flyoob/NanoVNA-F/Img/RF_Demo_Kit_Bot.jpg

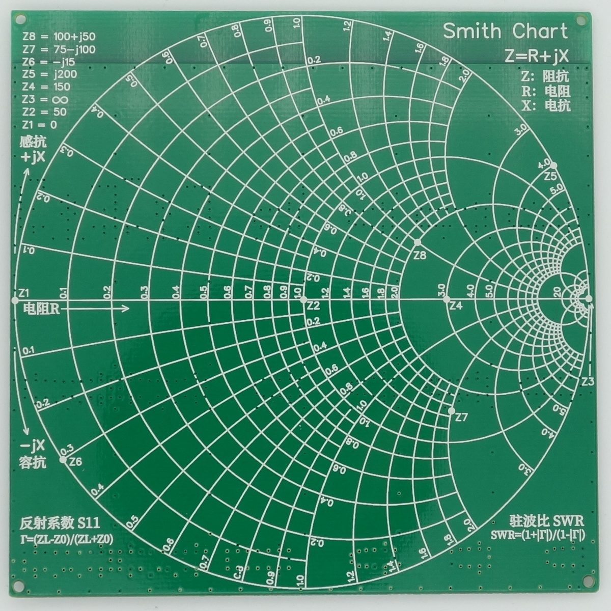
Img/RF_Demo_Kit_Bot.jpg
