flyoob/NanoVNA-F/Img/NanoVNA-F_PCB_V2.2_F.JPG

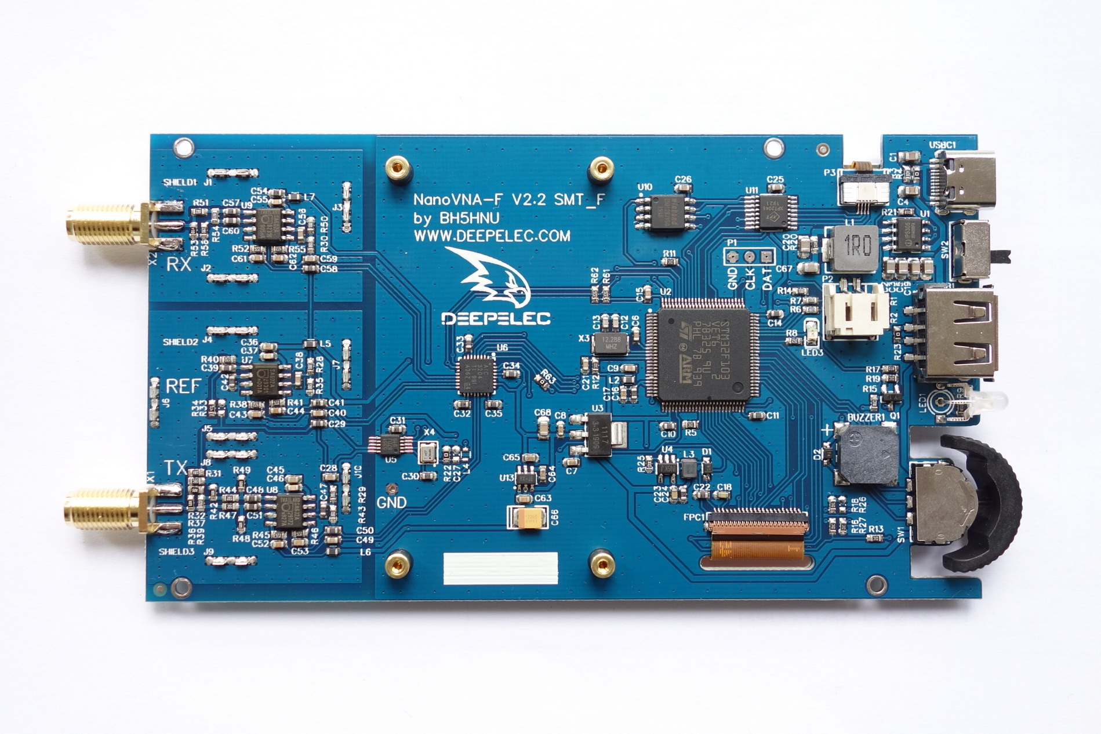
Img/NanoVNA-F_PCB_V2.2_F.JPG
