flyoob/NanoVNA-F/Img/NanoVNA-F_样品谍照1.JPG

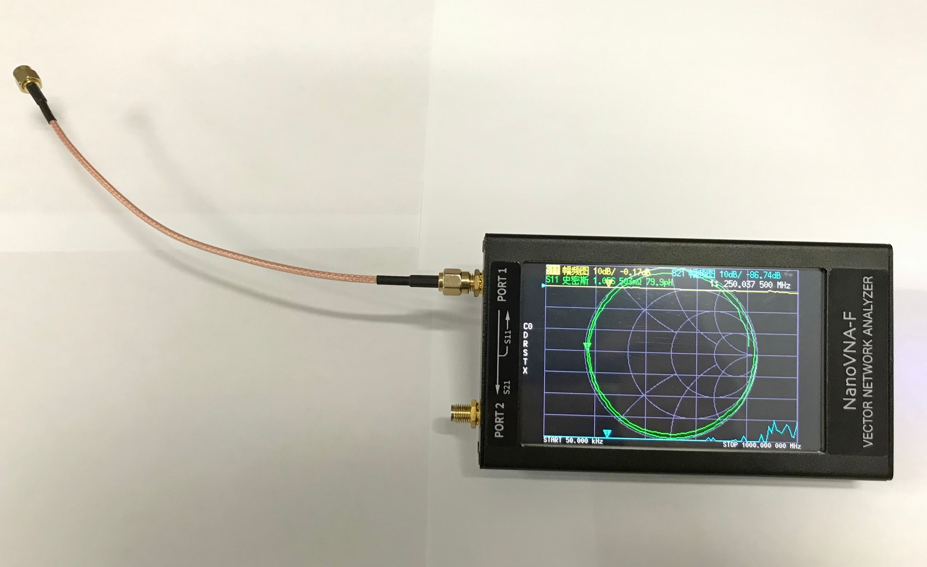
Img/NanoVNA-F_样品谍照1.JPG
