flyoob/NanoVNA-F/Img/RF_Demo_Kit_Top.jpg

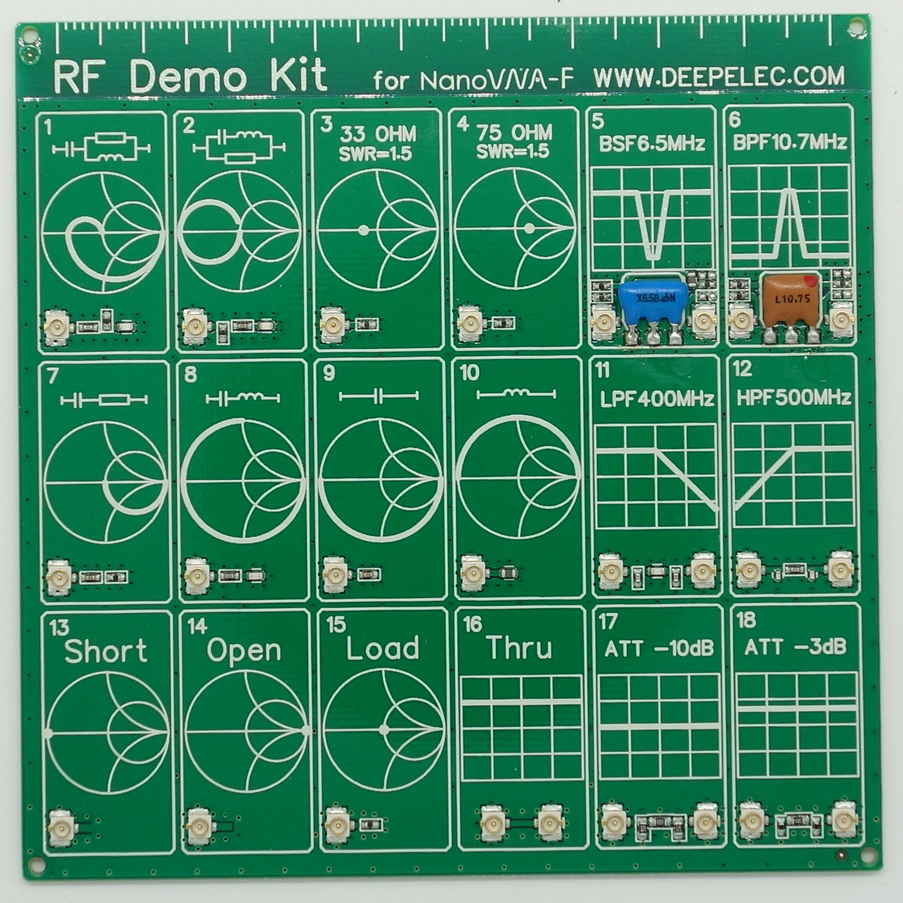
Img/RF_Demo_Kit_Top.jpg
