flyoob/NanoVNA-F/(threads)

Thread 6 (2019-11-22):

Update to 0.5.0 release

Constantin07, 2019-11-22:
Hi,

Are the any plans to update firmware to 0.5.0 release based on  https://github.com/ttrftech/NanoVNA/releases ?

Thanks.

PS: Great work and good product by the way.

flyoob, 2019-12-04:
> Are the any plans to update firmware to 0.5.0 release based on

We prioritize bug fixes, and new features released by edy555 will gradually follow up, please be patient ~

Closed 2019-12-04.

Thread 7 (2019-12-02):

Calibration problems at rev 0.0.4

derfunker, 2019-12-02:
Something is wrong with the CAL routines...
When doing S11 and S21 Calibration the errror terms are displayed on screen as described.
But when the correction is activated only the S11 trace is corrected!
Only when I have one trace (S21) on screen the correction works.
In some cases the S11 sweep only works when the marker is set e.g. to center.
I think here are some minor software bugs to find. In principle the device works fine! Thank you!

derfunker, 2019-12-02:
I found it. The bug was sitting in front of the device :-) Now I was successful with the Cal.

flyoob, 2019-12-04:
Thank you for your feedback, we will continue to pay attention to this issue.

derfunker, 2019-12-04:
Thanks!
One question: what is the maximum rf input level at port 2 (in case of
measure of an active DUT) I would apriciate to know about any new software
updates.
Best regards, Klaus

BH5HNU <notifications@github.com> schrieb am Mi., 4. Dez. 2019, 12:49:

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

Thread 8 (2019-12-04):

Informational commands on the serial port: "version" and "info"

mihtjel, 2019-12-04:
Hello,
for NanoVNA-Saver, it would be a help if the following were implemented in the NanoVNA-F firmware:

1) A "version" command, returning something like, for example: "NanoVNA-F version 0.0.5"
Having the version number clearly separated by spaces from the rest of the string is an advantage for my current parsing method. ;-)

2) An "info" command, returning at least the string "NanoVNA-F" (in order to recognize the device), but preferably also for example the supported frequency span, and any additional features supported by the firmware revision. Should you include a "raw scan" command at some point, that could be noted there, for example.  This would allow the software to distinguish not just which functions are available, but also which versions of the functions, should they change over time in an incompatible manner.

Thank you for your support in developing NanoVNA-Saver! I am testing it out with the NanoVNA-F right now! :-)

flyoob, 2019-12-04:
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

OK, I will add these commands in the next firmware update.
Have fun with your -F machine ~ :-)

Closed 2019-12-30.

Thread 9 (2019-12-08):

Enhancement: capture command for screenshots

mihtjel, 2019-12-08:
The NanoVNA-H firmware and variants has a "capture" command which returns the raw screen data, which can be used to make screenshots of the device. I'm adding support for this to NanoVNA-Saver. If you were to add a similar facility to the NanoVNA-F firmware, I would want to support this as well. :-)

mihtjel, 2020-02-24:
I see that a capture command has been added. However, it seems to send erroneous data: Cyan is sent the same way as white, ie. as 0xFFFF. I think that's a bug?

Thread 16 (2020-03-28):

Overlapping text displayed

Constantin07, 2020-03-28:
In some situations the displayed text overlaps. See attached the screenshot.

In my opinion (my 2 cents), SWR doesn't need much space so may be can be moved a bit to right ?

Version: 0.1.4
HW: V2.2

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

Thread 17 (2020-04-05):

Enhancement: Cho45 or Android app compatability

intelmation, 2020-04-05:
The VNA-H series has a nice, albeit no longer updated, Android app written by Cho45.

Would be nice to makr the "F" work with it. I believe it's a "com port" issue as my app shows a communication port error and will not connect.

Thanks!

flyoob, 2020-04-14:
Hi, to connect to the Android App, you need:
for NanoVNA-F HW V2.2, use USB-C to USB-C (OTG required) cable;
for NanoVNA-F HW V3.1 & V2.3, use USB-C to USB-C (No OTG required) cable.
Please confirm that the correct cable is used, thank you !

dsiminiuk, 2020-07-26:
HW 3.1 and USB-C to USB-C cable works.

Thread 18 (2020-07-25):

Touch calbration

Red-Owl, 2020-07-25:
hi,
in the new release touch screen have a little problem to touch.
(before calibration, after calibration) after update a new version.
version 2.

Thread 23 (2020-11-04):

Quick Start Guide Error

ricknun, 2020-11-04:
"NanoVNA-F Quick start guide - Firmware 0.2.1", 24 Aug 2020, Release 3.1, CONFIG, ABOUT shows a display image. That image is very different than the image on the device.  See the image for what it should look like.
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

Thread 26 (2021-07-02):

Abandoned?

ikidd, 2021-07-02:
Just purchased a NanoVNC-F and I see this firmware is pretty old.  Getting errors on calibration about unplausible values and most of what I see says to update firmware.  Am I whistling in the wind to think this project will get attention in the future or did I buy a paperweight?
