flyoob/NanoVNA-F/nanoVNA-F schematic_rev2.pdf

# nanoVNA-F

## USB1

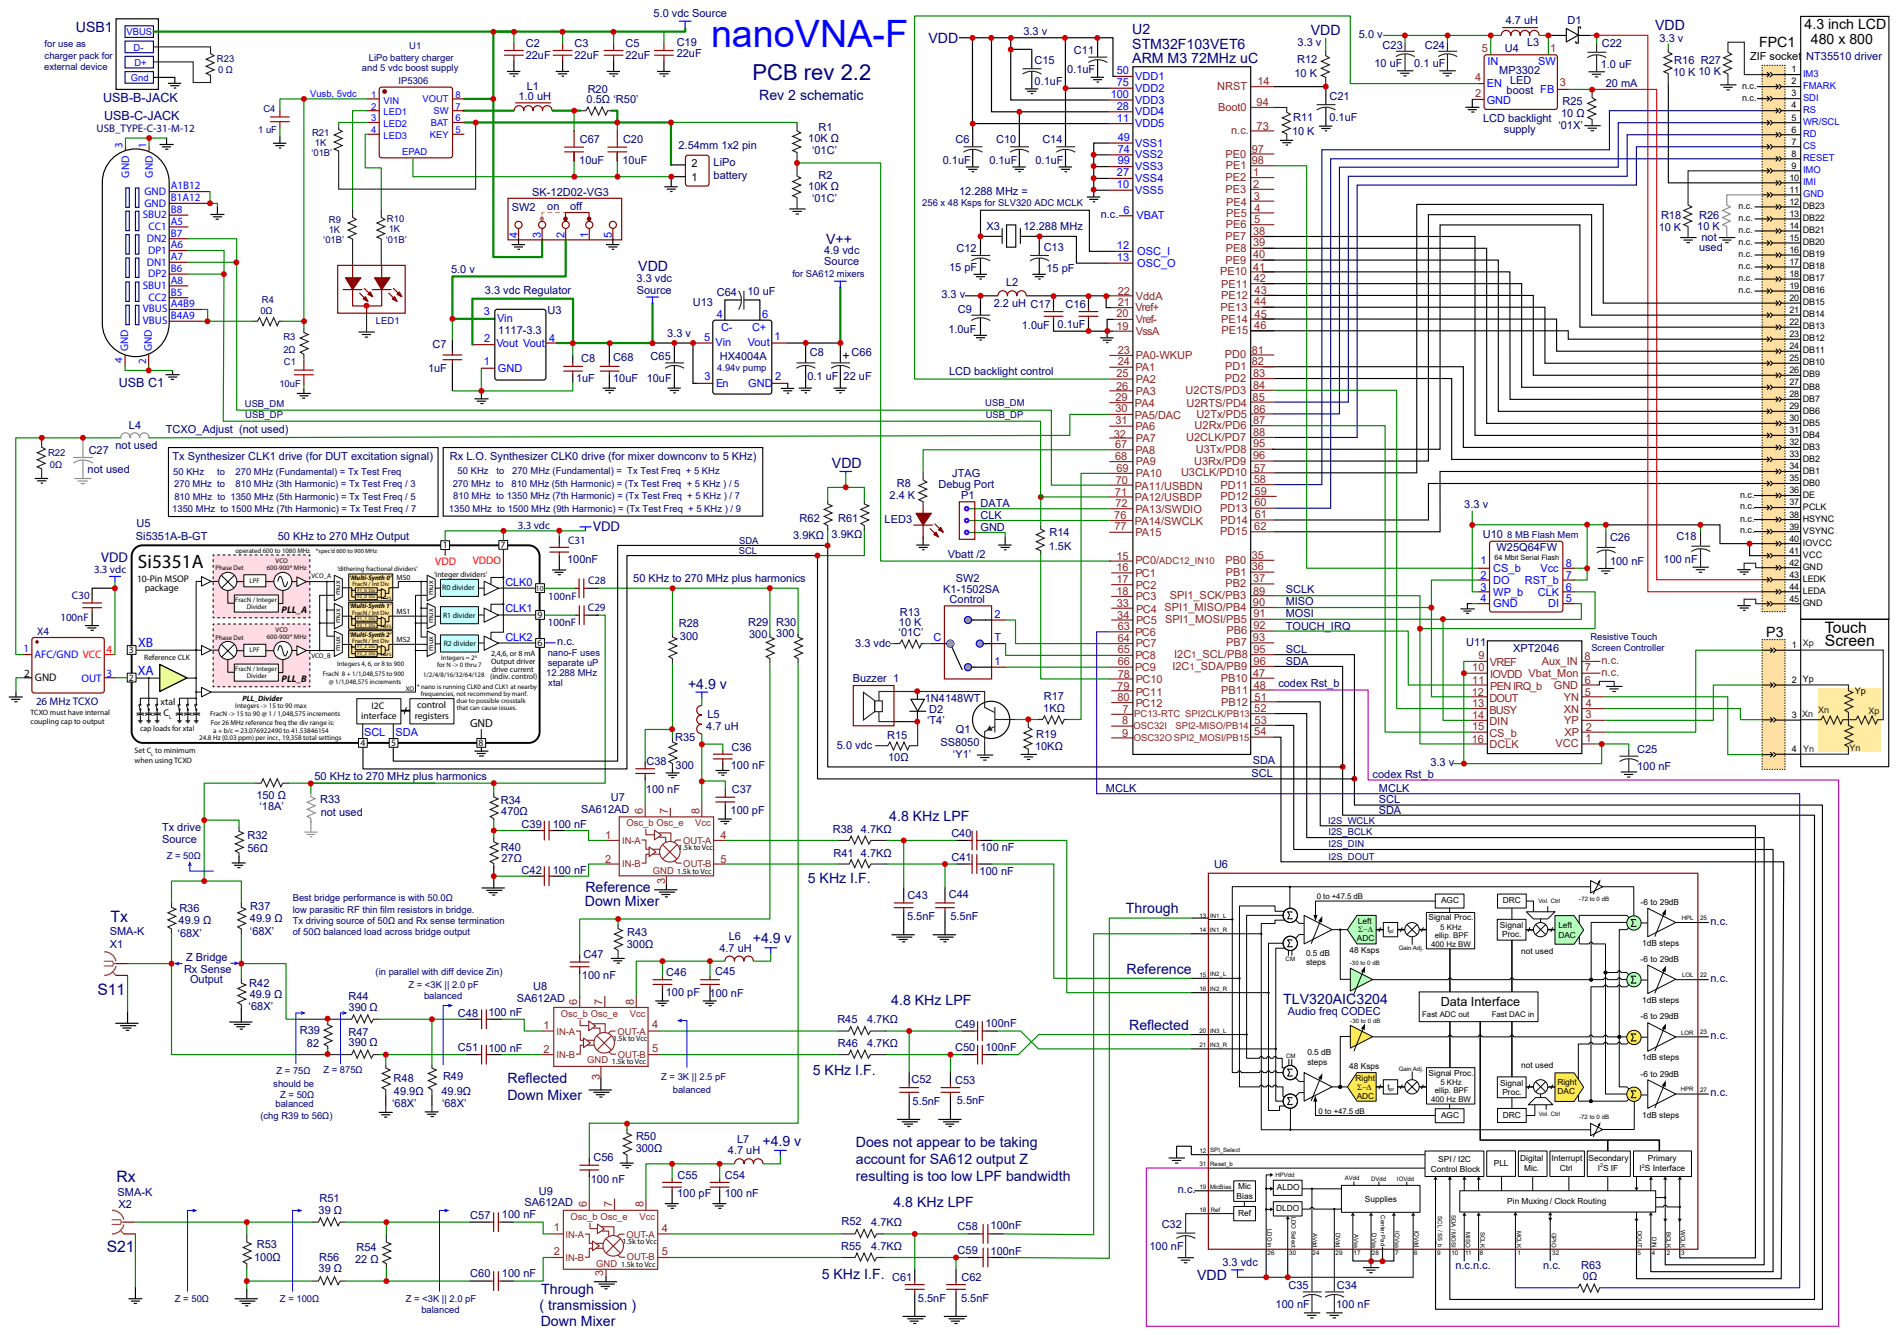
[picture p5: page 1]

12.288 MHz =
256 x 48 Ksps for SLV320 ADC MCLK

TCXO_Adjust (not used)
Tx Synthesizer CLK1 drive (for DUT excitation signal)
50 KHz to 270 MHz (Fundamental) = Tx Test Freq
270 MHz to 810 MHz (3th Harmonic) = Tx Test Freq / 3
810 MHz to 1350 MHz (5th Harmonic) = Tx Test Freq / 5
1350 MHz to 1500 MHz (7th Harmonic) = Tx Test Freq / 7
VDD

Rx L.O. Synthesizer CLK0 drive (for mixer downconv to 5 KHz)
50 KHz to 270 MHz (Fundamental) = Tx Test Freq + 5 KHz
270 MHz to 810 MHz (5th Harmonic) = (Tx Test Freq + 5 KHz ) / 5
810 MHz to 1350 MHz (7th Harmonic) = (Tx Test Freq + 5 KHz ) / 7
1350 MHz to 1500 MHz (9th Harmonic) = (Tx Test Freq + 5 KHz ) / 9

50 KHz to 270 MHz Output

operated 600 to 1080 MHz *spec’d 600 to 900 MHz

50 KHz to 270 MHz plus harmonics

Integers = 2N
for N -> 0 thru 7
* nano is running CLK0 and CLK1 at nearby
frequencies, not recommend by manf.
control
SDA
SCL

26 MHz TCXO
TCXO must have internal
coupling cap to output

xtal
cap loads for xtal

PLL_Divider
Integers -> 15 to 90 max
FracN -> 15 to 90 @ 1 / 1,048,575 increments
For 26 MHz reference freq the div range is:
24.8 Hz (0.03 ppm) per incr., 19,358 total settings

due to possible crosstalk
that can cause issues.

not used

MCLK | | MCLK

low parasitic RF thin film resistors in bridge.
Tx driving source of 50Ω and Rx sense termination
of 50Ω balanced load across bridge output

(in parallel with diff device Zin)
balanced

Does not appear to be taking
account for SA612 output Z
resulting is too low LPF bandwidth
4.8 KHz LPF

Pin Muxing / Clock Routing
