flyoob/NanoVNA-F/Src/main.c

/**
  ******************************************************************************
  * @file           : main.c
  * @brief          : Main program body
  ******************************************************************************
  * This notice applies to any and all portions of this file
  * that are not between comment pairs USER CODE BEGIN and
  * USER CODE END. Other portions of this file, whether 
  * inserted by the user or by software development tools
  * are owned by their respective copyright owners.
  *
  * Copyright (c) 2019 STMicroelectronics International N.V. 
  * All rights reserved.
  *
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
  ******************************************************************************
  */
/* Includes ------------------------------------------------------------------*/
#include "main.h"
#include "stm32f1xx_hal.h"
#include "cmsis_os.h"
#include "fatfs.h"
#include "usb_device.h"

/* USER CODE BEGIN Includes */
#include "board.h"
/* USER CODE END Includes */

ADC_HandleTypeDef hadc1;
ADC_HandleTypeDef hadc2;

I2S_HandleTypeDef hi2s2;
DMA_HandleTypeDef hdma_spi2_rx;

SPI_HandleTypeDef hspi1;
DMA_HandleTypeDef hdma_spi1_tx;
DMA_HandleTypeDef hdma_spi1_rx;

TIM_HandleTypeDef htim1;
TIM_HandleTypeDef htim2;
DMA_HandleTypeDef hdma_tim1_ch3;

SRAM_HandleTypeDef hsram1;

osThreadId Task001Handle;
osThreadId TaskCmdHandle;

/* USER CODE BEGIN PV */
FIL fil;
UINT size;
char callsign[11];
/* USER CODE END PV */

void SystemClock_Config(void);
static void MX_GPIO_Init(void);
static void MX_DMA_Init(void);
static void MX_FSMC_Init(void);
static void MX_I2S2_Init(void);
static void MX_TIM1_Init(void);
static void MX_SPI1_Init(void);
static void MX_TIM2_Init(void);
static void MX_ADC2_Init(void);
static void MX_ADC1_Init(void);
void StartTask001(void const * argument);
void StartTaskCmd(void const * argument);

void HAL_TIM_MspPostInit(TIM_HandleTypeDef *htim);
                                
                                

/* USER CODE BEGIN PFP */
extern void app_init(void);
extern void app_loop(void);
extern void cmd_init(void);
extern void cmd_loop(void);

static void MY_USBDP_IO_Init(void)
{
  GPIO_InitTypeDef GPIO_InitStruct;

  HAL_GPIO_WritePin(GPIOC, GPIO_PIN_10, GPIO_PIN_SET);

  GPIO_InitStruct.Pin = GPIO_PIN_10;
  GPIO_InitStruct.Mode = GPIO_MODE_OUTPUT_PP;
  GPIO_InitStruct.Pull = GPIO_PULLUP;
  GPIO_InitStruct.Speed = GPIO_SPEED_FREQ_HIGH;
  HAL_GPIO_Init(GPIOC, &GPIO_InitStruct);
}

static void MX_SPI1_Init_SF(void)
{

  /* SPI1 parameter configuration*/
  hspi1.Instance = SPI1;
  hspi1.Init.Mode = SPI_MODE_MASTER;
  hspi1.Init.Direction = SPI_DIRECTION_2LINES;
  hspi1.Init.DataSize = SPI_DATASIZE_8BIT;
  hspi1.Init.CLKPolarity = SPI_POLARITY_HIGH;
  hspi1.Init.CLKPhase = SPI_PHASE_2EDGE;
  hspi1.Init.NSS = SPI_NSS_SOFT;
  hspi1.Init.BaudRatePrescaler = SPI_BAUDRATEPRESCALER_2;
  hspi1.Init.FirstBit = SPI_FIRSTBIT_MSB;
  hspi1.Init.TIMode = SPI_TIMODE_DISABLE;
  hspi1.Init.CRCCalculation = SPI_CRCCALCULATION_DISABLE;
  hspi1.Init.CRCPolynomial = 10;
  if (HAL_SPI_Init(&hspi1) != HAL_OK)
  {
    _Error_Handler(__FILE__, __LINE__);
  }

}
/* USER CODE END PFP */

/**
  * @brief  The application entry point.
  *
  * @retval None
  */
int main(void)
{
  /* USER CODE BEGIN 1 */
  SCB->VTOR = FLASH_BASE | FLASH_BOOT_SIZE;
  /* USER CODE END 1 */

  /* MCU Configuration----------------------------------------------------------*/

  /* Reset of all peripherals, Initializes the Flash interface and the Systick. */
  HAL_Init();

  /* Configure the system clock */
  SystemClock_Config();

  /* Initialize all configured peripherals */
  MX_GPIO_Init();
  MX_DMA_Init();
  MX_FSMC_Init();
  MX_I2S2_Init();
  MX_TIM1_Init();
  MX_TIM2_Init();
  MX_ADC2_Init();
  MX_ADC1_Init();
  /* USER CODE BEGIN 2 */
  __enable_irq();
  /* USER CODE END 2 */

  /* USER CODE BEGIN RTOS_MUTEX */
  /* add mutexes, ... */
  /* USER CODE END RTOS_MUTEX */

  /* USER CODE BEGIN RTOS_SEMAPHORES */
  /* add semaphores, ... */
  /* USER CODE END RTOS_SEMAPHORES */

  /* USER CODE BEGIN RTOS_TIMERS */
  /* start timers, add new ones, ... */
  /* USER CODE END RTOS_TIMERS */

  /* Create the thread(s) */
  /* definition and creation of Task001 */
  osThreadDef(Task001, StartTask001, osPriorityNormal, 0, 512);
  Task001Handle = osThreadCreate(osThread(Task001), NULL);

  /* definition and creation of TaskCmd */
  osThreadDef(TaskCmd, StartTaskCmd, osPriorityNormal, 0, 512);
  TaskCmdHandle = osThreadCreate(osThread(TaskCmd), NULL);

  /* USER CODE BEGIN RTOS_THREADS */
  /* add threads, ... */
  /* USER CODE END RTOS_THREADS */

  /* USER CODE BEGIN RTOS_QUEUES */
  /* add queues, ... */
  /* USER CODE END RTOS_QUEUES */
 

  /* Start scheduler */
  osKernelStart();
  
  /* We should never get here as control is now taken by the scheduler */

  /* Infinite loop */
  /* USER CODE BEGIN WHILE */
  while (1)
  {

  /* USER CODE END WHILE */

  /* USER CODE BEGIN 3 */

  }
  /* USER CODE END 3 */

}

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
/* USER CODE BEGIN Header_StartTask001 */
/**
  * @brief  Function implementing the MyTask001 thread.
  * @param  argument: Not used 
  * @retval None
  */
/* USER CODE END Header_StartTask001 */
void StartTask001(void const * argument)
{
  /* USER CODE BEGIN 5 */
  MY_USBDP_IO_Init();
  MX_USB_DEVICE_Init();

  MX_SPI1_Init_SF();

  // Register
  MX_FATFS_Init();
  if (retUSER != 0) {
    goto INIT;
  }
  // Mount
  if (f_mount(&USERFatFS, (TCHAR const*)USERPath, 1) != FR_OK) {
    goto INIT;
  }
  // Open Callsign File
  callsign[0] = 0; // (nul == null char) init nul callsign before use
 
  // consider callsign <"abcdefghil0123456789\r\n\0"|"abcdefghil0123456789\n\0"|"abcdefghil0123456789\0">
  if (f_open(&fil, "callsign.txt", FA_OPEN_EXISTING | FA_READ) == FR_OK) {
    DWORD size;
   
    f_lseek(&fil, 0);
   
    if ((size = f_size(&fil)) > 0) {
      UINT cp;
     
      f_read(&fil, (uint8_t *)callsign, 10, &size); // load max 10 chars
     
      if (size < 11) { callsign[size] = 0; } // 11 == CMAX+1
      else { callsign[10] = 0; } // truncate at 10th char
     
      for (cp = 0; callsign[cp] != '\r' && callsign[cp] != '\n' && callsign[cp] != 0; cp++); // lazy eval: find \r or \n or null
     
      if (callsign[cp] != 0) { callsign[cp] = 0; } // nul terminate else no-op
    } // (size > 0) else no-op
  } // FR_OK else no-op
 
  f_close(&fil);
  // Unmount
  f_mount(NULL, (TCHAR const*)USERPath, 1);

INIT:
  HAL_SPI_DeInit(&hspi1);
  MX_SPI1_Init();

  app_init();
  /* Infinite loop */
  for(;;)
  {
    app_loop();
    osDelay(1);
  }
  /* USER CODE END 5 */ 
}

/* USER CODE BEGIN Header_StartTaskCmd */
/**
* @brief Function implementing the myTaskCmd thread.
* @param argument: Not used
* @retval None
*/
/* USER CODE END Header_StartTaskCmd */
void StartTaskCmd(void const * argument)
{
  /* USER CODE BEGIN StartTaskCmd */
  cmd_init();
  /* Infinite loop */
  for(;;)
  {
    cmd_loop();
    osDelay(1);
  }
  /* USER CODE END StartTaskCmd */
}

/**
  * @brief  Period elapsed callback in non blocking mode
  * @note   This function is called  when TIM4 interrupt took place, inside
  * HAL_TIM_IRQHandler(). It makes a direct call to HAL_IncTick() to increment
  * a global variable "uwTick" used as application time base.
  * @param  htim : TIM handle
  * @retval None
  */
void HAL_TIM_PeriodElapsedCallback(TIM_HandleTypeDef *htim)
{
  if (htim->Instance == TIM4) {
    HAL_IncTick();
  }
  /* USER CODE BEGIN Callback 1 */
  beep_tick();
  /* USER CODE END Callback 1 */
}

/**
  * @brief  This function is executed in case of error occurrence.
  * @param  file: The file name as string.
  * @param  line: The line in file as a number.
  * @retval None
  */
void _Error_Handler(char *file, int line)
{
  /* USER CODE BEGIN Error_Handler_Debug */
  /* User can add his own implementation to report the HAL error return state */
  printf("_Error_Handler %s(%d)-<%s>: \r\n",__FILE__, __LINE__, __FUNCTION__);
  while(1)
  {
  }
  /* USER CODE END Error_Handler_Debug */
}

#ifdef  USE_FULL_ASSERT
/**
  * @brief  Reports the name of the source file and the source line number
  *         where the assert_param error has occurred.
  * @param  file: pointer to the source file name
  * @param  line: assert_param error line source number
  * @retval None
  */
void assert_failed(uint8_t* file, uint32_t line)
{ 
  /* USER CODE BEGIN 6 */
  /* User can add his own implementation to report the file name and line number,
     tex: printf("Wrong parameters value: file %s on line %d\r\n", file, line) */
  /* USER CODE END 6 */
}
#endif /* USE_FULL_ASSERT */

/**
  * @}
  */

/**
  * @}
  */

/************************ (C) COPYRIGHT STMicroelectronics *****END OF FILE****/
