flyoob/NanoVNA-F/NanoVNA-F.ioc

Mcu.UserName=STM32F103VETx
PA10.GPIO_Label=BEEP
PA10.Signal=S_TIM1_CH3
PA11.Signal=USB_DM
PA12.Signal=USB_DP
PA13.Signal=SYS_JTMS-SWDIO
PA14.Signal=SYS_JTCK-SWCLK
PA2.GPIO_Label=LED_PWM
PA2.Signal=S_TIM2_CH3
PA8.GPIO_Label=LED1
PA8.Signal=GPIO_Output
PB11.GPIO_Label=AIC_RST
PB11.Signal=GPIO_Output
PB12.GPIO_Label=I2S_WCLK
PB12.Signal=I2S2_WS
PB13.GPIO_Label=I2S_BCLK
PB13.Signal=I2S2_CK
PB15.GPIO_Label=I2S_DOUT
PB15.Signal=I2S2_SD
PB3.GPIO_Label=SPI_SCK
PB3.Signal=SPI1_SCK
PB4.GPIO_Label=SPI_MISO
PB4.Signal=SPI1_MISO
PB5.GPIO_Label=SPI_MOSI
PB5.Signal=SPI1_MOSI
PB6.GPIO_Label=TP_IRQ
PB6.Signal=GPXTI6
PC0.GPIO_Label=BAT_ADC
PC0.Signal=ADCx_IN10
PC6.Signal=I2S2_MCK
PC7.GPIO_Label=K_UP
PC7.Signal=GPXTI7
PC8.GPIO_Label=K_PUSH
PC8.Signal=GPXTI8
PC9.GPIO_Label=K_DOWN
PC9.Signal=GPXTI9
PD0.Signal=FSMC_D2
PD1.Signal=FSMC_D3
PD10.Signal=FSMC_D15
PD11.Signal=FSMC_A16
PD13.GPIO_Label=LCD_RST
PD13.Signal=GPIO_Output
PD14.Signal=FSMC_D0
PD15.Signal=FSMC_D1
PD3.GPIO_Label=TP_BUSY
PD3.Signal=GPIO_Input
PD4.Signal=FSMC_NOE
PD5.Signal=FSMC_NWE
PD6.GPIO_Label=SPI_CS0
PD6.Signal=GPIO_Output
PD7.Signal=FSMC_NE1
PD8.Signal=FSMC_D13
PD9.Signal=FSMC_D14
PE1.GPIO_Label=SPI_CS1
PE1.Signal=GPIO_Output
PE10.Signal=FSMC_D7
PE11.Signal=FSMC_D8
PE12.Signal=FSMC_D9
PE13.Signal=FSMC_D10
PE14.Signal=FSMC_D11
PE15.Signal=FSMC_D12
PE7.Signal=FSMC_D4
PE8.Signal=FSMC_D5
PE9.Signal=FSMC_D6
