flyoob/NanoVNA-F/Usr/plot.c

#include <math.h>
#include <string.h>
#include "system.h"
#include "cmsis_os.h"
#include "board.h"
#include "nanovna.h"

#define SWAP(x,y) do { int z=x; x = y; y = z; } while(0)

void cell_draw_marker_info(int m, int n, int w, int h);
void draw_frequencies(void);
void frequency_string(char *buf, size_t len, int32_t freq);
void markmap_all_markers(void);

/* indicate dirty cells */
uint16_t markmap[2][8];
uint16_t current_mappage = 0;

int32_t fgrid = 50000000;
int16_t grid_offset;
int16_t grid_width;

int area_width = AREA_WIDTH_NORMAL;
int area_height = HEIGHT;

#define GRID_RECTANGULAR (1<<0)
#define GRID_SMITH       (1<<1)
#define GRID_ADMIT       (1<<2)
#define GRID_POLAR       (1<<3)


#define CELLWIDTH        32
#define CELLHEIGHT       32

/*
 * CELL_X0[27:31] cell position 0-31
 * CELL_Y0[22:26] cell position 0-31
 * CELL_N[10:21]  original order 0-4095
 * CELL_X[5:9]    position in the cell 0-31
 * CELL_Y[0:4]    position in the cell 0-31
 */
uint32_t trace_index[TRACES_MAX][SWEEP_POINTS];

#define INDEX(x, y, n) \
  ((((x)&0x03e0UL)<<22) | (((y)&0x03e0UL)<<17) | (((n)&0x0fffUL)<<10)  \
 | (((x)&0x1fUL)<<5) | ((y)&0x1fUL))

#define CELL_X(i)          (int)((((i)>>5)&0x1f) | (((i)>>22)&0x03e0))
#define CELL_Y(i)          (int)(((i)&0x1f) | (((i)>>17)&0x03e0))
#define CELL_N(i)          (int)(((i)>>10)&0xfff)

#define CELL_X0(i)         (int)(((i)>>22)&0x03e0)  // 10bit中的高5bit
#define CELL_Y0(i)         (int)(((i)>>17)&0x03e0)  // 10bit中的高5bit

#define CELL_P(i, x, y)    (((((x)&0x03e0UL)<<22) | (((y)&0x03e0UL)<<17)) == ((i)&0xffc00000UL))


void update_grid(void)
{
  int32_t gdigit = 100000000; // 100M
  int32_t fstart, fspan;
  int32_t grid;
  if (frequency1 > 0) {
    fstart = frequency0;
    fspan = frequency1 - frequency0;
  } else {
    fspan = -frequency1;
    fstart = frequency0 - fspan/2;
  }
  
  while (gdigit > 100) {
    grid = 5 * gdigit;
    if (fspan / grid >= 4)
      break;
    grid = 2 * gdigit;
    if (fspan / grid >= 4)
      break;
    grid = gdigit;
    if (fspan / grid >= 4)
      break;
    gdigit /= 10;
  }
  fgrid = grid;

  grid_offset = (WIDTH-1) * ((fstart % fgrid) / 100) / (fspan / 100);
  grid_width = (WIDTH-1) * (fgrid / 100) / (fspan / 1000);

  force_set_markmap();
  draw_frequencies();
}

int
circle_inout(int x, int y, int r)
{
  int d = x*x + y*y - r*r;
  if (d <= -r)
    return 1;
  if (d > r)
    return -1;
  return 0;
}

#if USE_ILI_LCD

#define P_CENTER_X      146
#define P_CENTER_Y      116
#define P_RADIUS        116

#else

#define P_CENTER_X    ((WIDTH-1)/2)
#define P_CENTER_Y      116
#define P_RADIUS        116

#endif

int
polar_grid(int x, int y)
{
  int c = config.grid_color;
  int d;

  // offset to center
  x -= P_CENTER_X;
  y -= P_CENTER_Y;

  // outer circle
  d = circle_inout(x, y, P_RADIUS);
  if (d < 0) return 0;
  if (d == 0) return c;

  // vertical and horizontal axis
  if (x == 0 || y == 0)
    return c;

  d = circle_inout(x, y, P_RADIUS / 5);
  if (d == 0) return c;
  if (d > 0) return 0;

  d = circle_inout(x, y, P_RADIUS * 2 / 5);
  if (d == 0) return c;
  if (d > 0) return 0;

  // cross sloping lines
  if (x == y || x == -y)
    return c;

  d = circle_inout(x, y, P_RADIUS * 3 / 5);
  if (d == 0) return c;
  if (d > 0) return 0;

  d = circle_inout(x, y, P_RADIUS * 4 / 5);
  if (d == 0) return c;
  return 0;
}

/*
 * Constant Resistance circle: (u - r/(r+1))^2 + v^2 = 1/(r+1)^2
 * Constant Reactance circle:  (u - 1)^2 + (v-1/x)^2 = 1/x^2
 */
int
smith_grid(int x, int y)
{
  int c = config.grid_color;
  int d;

  // offset to center
  x -= P_CENTER_X;
  y -= P_CENTER_Y;
  
  // outer circle
  d = circle_inout(x, y, P_RADIUS);
  if (d < 0)
    return 0;
  if (d == 0)
    return c;
  
  // horizontal axis
  if (y == 0)
    return c;

  // shift circle center to right origin
  x -= P_RADIUS;

  // Constant Reactance Circle: 2j : R/2 = 58
  if (circle_inout(x, y+58, 58) == 0)
    return c;
  if (circle_inout(x, y-58, 58) == 0)
    return c;

  // Constant Resistance Circle: 3 : R/4 = 29
  d = circle_inout(x+29, y, 29);
  if (d > 0) return 0;
  if (d == 0) return c;

  // Constant Reactance Circle: 1j : R = 116
  if (circle_inout(x, y+116, 116) == 0)
    return c;
  if (circle_inout(x, y-116, 116) == 0)
    return c;

  // Constant Resistance Circle: 1 : R/2 = 58
  d = circle_inout(x+58, y, 58);
  if (d > 0) return 0;
  if (d == 0) return c;

  // Constant Reactance Circle: 1/2j : R*2 = 232
  if (circle_inout(x, y+232, 232) == 0)
    return c;
  if (circle_inout(x, y-232, 232) == 0)
    return c;

  // Constant Resistance Circle: 1/3 : R*3/4 = 87
  if (circle_inout(x+87, y, 87) == 0)
    return c;
  return 0;
}

int
smith_grid2(int x, int y, float scale)
{
  int c = config.grid_color;
  int d;

  // offset to center
  x -= P_CENTER_X;
  y -= P_CENTER_Y;
  
  // outer circle
  d = circle_inout(x, y, P_RADIUS);
  if (d < 0)
    return 0;
  if (d == 0)
    return c;

  // shift circle center to right origin
  x -= P_RADIUS * scale;

  // Constant Reactance Circle: 2j : R/2 = 58
  if (circle_inout(x, y+58*scale, 58*scale) == 0)
    return c;
  if (circle_inout(x, y-58*scale, 58*scale) == 0)
    return c;
#if 0
  // Constant Resistance Circle: 3 : R/4 = 29
  d = circle_inout(x+29*scale, y, 29*scale);
  if (d > 0) return 0;
  if (d == 0) return c;
  d = circle_inout(x-29*scale, y, 29*scale);
  if (d > 0) return 0;
  if (d == 0) return c;
#endif

  // Constant Reactance Circle: 1j : R = 116
  if (circle_inout(x, y+116*scale, 116*scale) == 0)
    return c;
  if (circle_inout(x, y-116*scale, 116*scale) == 0)
    return c;

  // Constant Resistance Circle: 1 : R/2 = 58
  d = circle_inout(x+58*scale, y, 58*scale);
  if (d > 0) return 0;
  if (d == 0) return c;
  d = circle_inout(x-58*scale, y, 58*scale);
  if (d > 0) return 0;
  if (d == 0) return c;

  // Constant Reactance Circle: 1/2j : R*2 = 232
  if (circle_inout(x, y+232*scale, 232*scale) == 0)
    return c;
  if (circle_inout(x, y-232*scale, 232*scale) == 0)
    return c;

#if 0
  // Constant Resistance Circle: 1/3 : R*3/4 = 87
  d = circle_inout(x+87*scale, y, 87*scale);
  if (d > 0) return 0;
  if (d == 0) return c;
  d = circle_inout(x+87*scale, y, 87*scale);
  if (d > 0) return 0;
  if (d == 0) return c;
#endif

  // Constant Resistance Circle: 0 : R
  d = circle_inout(x+P_RADIUS*scale, y, P_RADIUS*scale);
  if (d > 0) return 0;
  if (d == 0) return c;
  d = circle_inout(x-P_RADIUS*scale, y, P_RADIUS*scale);
  if (d > 0) return 0;
  if (d == 0) return c;

  // Constant Resistance Circle: -1/3 : R*3/2 = 174
  d = circle_inout(x+174*scale, y, 174*scale);
  if (d > 0) return 0;
  if (d == 0) return c;
  d = circle_inout(x-174*scale, y, 174*scale);
  //if (d > 0) return 0;
  if (d == 0) return c;
  return 0;
}


const int cirs[][4] = {
  { 0, 58/2, 58/2, 0 },    // Constant Reactance Circle: 2j : R/2 = 58
  { 29/2, 0, 29/2, 1 },    // Constant Resistance Circle: 3 : R/4 = 29
  { 0, 116/2, 116/2, 0 },  // Constant Reactance Circle: 1j : R = 116
  { 58/2, 0, 58/2, 1 },    // Constant Resistance Circle: 1 : R/2 = 58
  { 0, 232/2, 232/2, 0 },  // Constant Reactance Circle: 1/2j : R*2 = 232
  { 87/2, 0, 87/2, 1 },    // Constant Resistance Circle: 1/3 : R*3/4 = 87
  { 0, 464/2, 464/2, 0 },  // Constant Reactance Circle: 1/4j : R*4 = 464
  { 116/2, 0, 116/2, 1 },  // Constant Resistance Circle: 0 : R
  { 174/2, 0, 174/2, 1 },  // Constant Resistance Circle: -1/3 : R*3/2 = 174
  { 0, 0, 0, 0 } // sentinel
};  

int
smith_grid3(int x, int y)
{
  int c = config.grid_color;
  int d;

  // offset to center
  x -= P_CENTER_X;
  y -= P_CENTER_Y;
  
  // outer circle
  d = circle_inout(x, y, P_RADIUS);
  if (d < 0)
    return 0;
  if (d == 0)
    return c;

  // shift circle center to right origin
  x -= P_RADIUS /2;

  int i;
  for (i = 0; cirs[i][2]; i++) {
    d = circle_inout(x+cirs[i][0], y+cirs[i][1], cirs[i][2]);
    if (d == 0)
      return c;
    if (d > 0 && cirs[i][3])
      return 0;
    d = circle_inout(x-cirs[i][0], y-cirs[i][1], cirs[i][2]);
    if (d == 0)
      return c;
    if (d > 0 && cirs[i][3])
      return 0;
  }
  return 0;
}

#if 0
int
rectangular_grid(int x, int y)
{
  int c = config.grid_color;
  //#define FREQ(x) (((x) * (fspan / 1000) / (WIDTH-1)) * 1000 + fstart)
  //int32_t n = FREQ(x-1) / fgrid;
  //int32_t m = FREQ(x) / fgrid;
  //if ((m - n) > 0)
  //if (((x * 6) % (WIDTH-1)) < 6)
  //if (((x - grid_offset) % grid_width) == 0)
  if (x == 0 || x == WIDTH-1)
    return c;
  if ((y % GRIDY) == 0)
    return c;
  if ((((x + grid_offset) * 10) % grid_width) < 10)
    return c;
  return 0;
}
#endif

int
rectangular_grid_x(int x)
{
  int c = config.grid_color;
  if (x < 0)
    return 0;
  if (x == 0 || x == WIDTH)
    return c;
  if ((((x + grid_offset) * 10) % grid_width) < 10)
    return c;
  return 0;
}

int
rectangular_grid_y(int y)
{
  int c = config.grid_color;
  if (y < 0)
    return 0;
  if ((y % GRIDY) == 0)
    return c;
  return 0;
}

#if 0
int
set_strut_grid(int x)
{
  uint16_t *buf = lcd_buffer;
  int y;

  for (y = 0; y < HEIGHT; y++) {
    int c = rectangular_grid(x, y);
    c |= smith_grid(x, y);
    *buf++ = c;
  }
  return y;
}

void
draw_on_strut(int v0, int d, int color)
{
  int v;
  int v1 = v0 + d;
  if (v0 < 0) v0 = 0;
  if (v1 < 0) v1 = 0;
  if (v0 >= HEIGHT) v0 = HEIGHT-1;
  if (v1 >= HEIGHT) v1 = HEIGHT-1;
  if (v0 == v1) {
    v = v0; d = 2;
  } else if (v0 < v1) {
    v = v0; d = v1 - v0 + 1;
  } else {
    v = v1; d = v0 - v1 + 1;
  }
  while (d-- > 0)
    lcd_buffer[v++] |= color;
}
#endif

/*
 * calculate log10(abs(gamma))
 */ 
float logmag(float *v)
{
  if (v[0] == 0 && v[1] == 0) {
    return -INFINITY;
  }
  return log10f(v[0]*v[0] + v[1]*v[1]);
}

/*
 * calculate phase[-2:2] of coefficient
 */ 
float phase(float *v)
{
  return 2 * atan2f(v[1], v[0]) / M_PI;
}

/*
 * calculate abs(gamma) * 8
 */ 
float linear(float *v)
{
  return - sqrtf(v[0]*v[0] + v[1]*v[1]) * 8;
}

/*
 * calculate vswr; (1+gamma)/(1-gamma)
 */ 
float swr(float *v)
{
  float x = sqrtf(v[0]*v[0] + v[1]*v[1]);
  if (x > 1)
    return INFINITY;
  return (1 + x)/(1 - x);
}

#define RADIUS ((HEIGHT-1)/2)
void
cartesian_scale(float re, float im, int *xp, int *yp, float scale)
{
  //float scale = 4e-3;
  int x = re * RADIUS * scale;
  int y = im * RADIUS * scale;
  if (x < -RADIUS) x = -RADIUS;
  if (y < -RADIUS) y = -RADIUS;
  if (x > RADIUS) x = RADIUS;
  if (y > RADIUS) y = RADIUS;
  *xp = WIDTH/2 + x;
  *yp = HEIGHT/2 - y;
}

/*
=======================================
    x: 每条曲线上点的 X 坐标
    t: 曲线标号
    i: 对应第几个点
=======================================
*/
uint32_t trace_into_index(int x, int t, int i, float coeff[2])
{
  int y = 0;
  float v = 0;
  float refpos = 8 - trace[t].refpos;
  float scale = 1 / trace[t].scale;
  switch (trace[t].type) {
  case TRC_LOGMAG:
    v = refpos - logmag(coeff) * scale;  // t=1, 1-(-3.1) logmag(0)=0
    break;
  case TRC_PHASE:
    v = refpos - phase(coeff) * scale;
    break;
  case TRC_LINEAR:
    v = refpos + linear(coeff) * scale;
    break;
  case TRC_SWR:
    v = refpos+ (1 - swr(coeff)) * scale;
    break;
  case TRC_SMITH:
  //case TRC_ADMIT:
  case TRC_POLAR:
    cartesian_scale(coeff[0], coeff[1], &x, &y, scale);
    return INDEX(x +CELLOFFSETX, y, i);
    // break;
  }
  if (v < 0) v = 0;
  if (v > 8) v = 8;
  y = v * GRIDY;
  return INDEX(x +CELLOFFSETX, y, i);
}

int
string_value_with_prefix(char *buf, int len, float val, char unit)
{
  char prefix;
  int n;
  if (val < 0) {
    val = -val;
    *buf++ = '-';
    len--;
  }
  if (val < 1e-12) {
    prefix = 'f';
    val *= 1e15;
  } else if (val < 1e-9) {
    prefix = 'p';
    val *= 1e12;
  } else if (val < 1e-6) {
    prefix = 'n';
    val *= 1e9;
  } else if (val < 1e-3) {
    prefix = S_MICRO[0];
    val *= 1e6;
  } else if (val < 1) {
    prefix = 'm';
    val *= 1e3;
  } else if (val < 1e3) {
    prefix = 0;
  } else if (val < 1e6) {
    prefix = 'k';
    val /= 1e3;
  } else if (val < 1e9) {
    prefix = 'M';
    val /= 1e6;
  } else {
    prefix = 'G';
    val /= 1e9;
  }

  if (val < 10) {
    n = chsnprintf(buf, len, "%.2f", val);
  } else if (val < 100) {
    n = chsnprintf(buf, len, "%.1f", val);
  } else {
    n = chsnprintf(buf, len, "%d", (int)val);
  }

  if (prefix)
    buf[n++] = prefix;
  if (unit)
    buf[n++] = unit;
  buf[n] = '\0';
  return n;
}


#define PI2 6.283184

void
gamma2imp(char *buf, int len, const float coeff[2], uint32_t frequency)
{
  // z = (gamma+1)/(gamma-1) * z0
  float z0 = 50;
  float d = z0 / ((1-coeff[0])*(1-coeff[0])+coeff[1]*coeff[1]);
  float zr = ((1+coeff[0])*(1-coeff[0]) - coeff[1]*coeff[1]) * d;  // real
  float zi = 2*coeff[1] * d;  // imag
  int n;

  n = string_value_with_prefix(buf, len, zr, S_OHM[0]);
  buf[n++] = ' ';

  if (zi < 0) {
    float c = -1 / (PI2 * frequency * zi);
    string_value_with_prefix(buf+n, len-n, c, 'F');
  } else {
    float l = zi / (PI2 * frequency);
    string_value_with_prefix(buf+n, len-n, l, 'H');
  }
}

void
trace_get_value_string(int t, char *buf, int len, float coeff[2], uint32_t frequency)
{
  float v;
  switch (trace[t].type) {
  case TRC_LOGMAG:
    v = logmag(coeff);
    if (v == -INFINITY)
      chsnprintf(buf, len, "-INF dB");
    else
      chsnprintf(buf, len, "%.2fdB", v * 10);
    break;
  case TRC_PHASE:
    v = phase(coeff);
    chsnprintf(buf, len, "%.2f" S_DEGREE, v * 90);
    break;
  case TRC_LINEAR:
    v = linear(coeff);
    chsnprintf(buf, len, "%.2f", v);
    break;
  case TRC_SWR:
    v = swr(coeff);
    if (v == INFINITY)
      chsnprintf(buf, len, "INF");
    else
      chsnprintf(buf, len, "%.2f", v);
    break;
  case TRC_SMITH:
    gamma2imp(buf, len, coeff, frequency);
    break;
  //case TRC_ADMIT:
  case TRC_POLAR:
    chsnprintf(buf, len, "%.2f %.2fj", coeff[0], coeff[1]);
    break;
  default:
    chsnprintf(buf, len, "");
    break;
  }
}

void
trace_get_info(int t, char *buf, int len)
{
  const char *type = trc_type_name[trace[t].type];
  switch (trace[t].type) {
  case TRC_LOGMAG:
    if (config.lang == LANG_CN)
      chsnprintf(buf, len, "%s %ddB/", "\x7F\x80\x81\x82\x83\x84", (int)(trace[t].scale*10));
    else
      chsnprintf(buf, len, "%s %ddB/", type, (int)(trace[t].scale*10));
    break;
  case TRC_PHASE:
    if (config.lang == LANG_CN)
      chsnprintf(buf, len, "%s %d" S_DEGREE "/", "\x85\x86\x81\x82\x83\x84", (int)(trace[t].scale*90));
    else
      chsnprintf(buf, len, "%s %d" S_DEGREE "/", type, (int)(trace[t].scale*90));
    break;
  case TRC_DELAY:
    if (config.lang == LANG_CN)
      chsnprintf(buf, len, "%s %.1f/", "\x87\x88\x89\x8A\x8B\x8C", trace[t].scale);
    else
      chsnprintf(buf, len, "%s %.1f/", type, trace[t].scale);
    break;
  case TRC_SMITH:
  //case TRC_ADMIT:
    if (config.lang == LANG_CN)
      chsnprintf(buf, len, "%s %.1fFS", "\x8D\x8E\x8F\x90\x91\x92", trace[t].scale);
    else
      chsnprintf(buf, len, "%s %.1fFS", type, trace[t].scale);
    break;
  case TRC_POLAR:
    if (config.lang == LANG_CN)
      chsnprintf(buf, len, "%s %.1fFS", "\x93\x94\x95\x96\x97\x98", trace[t].scale);
    else
      chsnprintf(buf, len, "%s %.1fFS", type, trace[t].scale);
    break;
  case TRC_LINEAR:
    if (config.lang == LANG_CN)
      chsnprintf(buf, len, "%s %.1f/", "\x7F\x80\x81\x82\x83\x84", trace[t].scale);
    else
      chsnprintf(buf, len, "%s %.1f/", type, trace[t].scale);
    break;
  case TRC_SWR:
    if (config.lang == LANG_CN)
      chsnprintf(buf, len, "%s %.1f/", "\x99\x9A\x9B\x9C\x9D\x9E", trace[t].scale);
    else
      chsnprintf(buf, len, "%s %.1f/", type, trace[t].scale);
    break;
  default:
    chsnprintf(buf, len, "%s %.1f/", type, trace[t].scale);
    break;
  }
}

/*
=======================================
    此处标记需要刷新的 CELL
=======================================
*/
static inline void
mark_map(int x, int y)
{
  if (y >= 0 && y < 8 && x >= 0 && x < 16)  // 对应 8*32=256 16*32=512
    markmap[current_mappage][y] |= 1<<x;
}

static inline int
is_mapmarked(int x, int y)
{
  uint16_t bit = 1<<x;
  return (markmap[0][y] & bit) || (markmap[1][y] & bit);
}

static inline void
markmap_upperarea(void)
{
  markmap[current_mappage][0] |= 0xffff;
}

static void
swap_markmap(void)
{
  current_mappage = 1 - current_mappage;
}

static inline void
clear_markmap(void)
{
  memset(markmap[current_mappage], 0, sizeof markmap[current_mappage]);
}

void
force_set_markmap(void)
{
  memset(markmap[current_mappage], 0xff, sizeof markmap[current_mappage]);
}

void
mark_cells_from_index(void)
{
  int t;
  /* mark cells between each neighber points */
  for (t = 0; t < TRACES_MAX; t++) {
    if (!trace[t].enabled)
      continue;
    int x0 = CELL_X(trace_index[t][0]);
    int y0 = CELL_Y(trace_index[t][0]);
    int m0 = x0 >> 5;
    int n0 = y0 >> 5;
    int i;
    mark_map(m0, n0);
    for (i = 1; i < sweep_points; i++) {
      int x1 = CELL_X(trace_index[t][i]);
      int y1 = CELL_Y(trace_index[t][i]);
      int m1 = x1 >> 5;
      int n1 = y1 >> 5;
      while (m0 != m1 || n0 != n1) {
        if (m0 == m1) {
          if (n0 < n1) n0++; else n0--;
        } else if (n0 == n1) {
          if (m0 < m1) m0++; else m0--;
        } else {
          int x = (m0 < m1) ? (m0 + 1)<<5 : m0<<5;
          int y = (n0 < n1) ? (n0 + 1)<<5 : n0<<5;
          int sgn = (n0 < n1) ? 1 : -1;
          if (sgn*(y-y0)*(x1-x0) < sgn*(x-x0)*(y1-y0)) {
            if (m0 < m1) m0++;
            else m0--;
          } else {
            if (n0 < n1) n0++;
            else n0--;
          }
        }
        mark_map(m0, n0);
      }
      x0 = x1;
      y0 = y1;
      m0 = m1;
      n0 = n1;
    }
  }
}

/*
=======================================
    标记要画的点
=======================================
*/
void plot_into_index(float measured[2][SWEEP_POINTS][2])
{
  int i, t;
  for (i = 0; i < sweep_points; i++) {
    int x = i * (WIDTH-1) / (sweep_points-1);  // WIDTH 为曲线区域宽度
    for (t = 0; t < TRACES_MAX; t++) {
      if (!trace[t].enabled)
        continue;
      int n = trace[t].channel;
      trace_index[t][i] = trace_into_index(x, t, i, measured[n][i]);
    }
  }
#if 0
  for (t = 0; t < TRACES_MAX; t++)
    if (trace[t].enabled && trace[t].polar)
      quicksort(trace_index[t], 0, sweep_points);
#endif

  mark_cells_from_index();  // 标记 CELL
  markmap_all_markers();
}

void
cell_drawline(int w, int h, int x0, int y0, int x1, int y1, int c)
{
  if (x0 > x1) {
    SWAP(x0, x1);
    SWAP(y0, y1);
  }

  while (x0 <= x1) {
    int dx = x1 - x0 + 1;
    int dy = y1 - y0;
    if (dy >= 0) {
      dy++;
      if (dy > dx) {
        dy /= dx; dx = 1;
      } else {
        dx /= dy; dy = 1;
      }
    } else {
      dy--;
      if (-dy > dx) {
        dy /= dx; dx = 1;
      } else {
        dx /= -dy; dy = -1;
      }
    }

    if (dx == 1) {
      if (dy > 0) {
        while (dy-- > 0) {
          if (y0 >= 0 && y0 < h && x0 >= 0 && x0 < w)
            lcd_buffer[y0*w+x0] |= c;
          y0++;
        }
      } else {
        while (dy++ < 0) {
          if (y0 >= 0 && y0 < h && x0 >= 0 && x0 < w)
            lcd_buffer[y0*w+x0] |= c;
          y0--;
        }
      }
      x0++;
    } else {
      while (dx-- > 0) {
        if (y0 >= 0 && y0 < h && x0 >= 0 && x0 < w)
          lcd_buffer[y0*w+x0] |= c;
        x0++;
      }
      y0 += dy;
    }
  }
}

int
search_index_range(int x, int y, uint32_t index[SWEEP_POINTS], int *i0, int *i1)
{
  int i, j;
  int head = 0;
  int tail = sweep_points;
  i = 0;
  x &= 0x03e0;
  y &= 0x03e0;
  while (head < tail) {
    i = (head + tail) / 2;
    if (x < CELL_X0(index[i]))
      tail = i+1;
    else if (x > CELL_X0(index[i]))
      head = i;
    else if (y < CELL_Y0(index[i]))
      tail = i+1;
    else if (y > CELL_Y0(index[i]))
      head = i;
    else
      break;
  }

  if (x != CELL_X0(index[i]) || y != CELL_Y0(index[i]))
    return FALSE;
    
  j = i;
  while (j > 0 && x == CELL_X0(index[j-1]) && y == CELL_Y0(index[j-1]))
    j--;
  *i0 = j;
  j = i;
  while (j < 100 && x == CELL_X0(index[j+1]) && y == CELL_Y0(index[j+1]))
    j++;
  *i1 = j;
  return TRUE;
}

int
search_index_range_x(int x, uint32_t index[SWEEP_POINTS], int *i0, int *i1)
{
  int i, j;
  int head = 0;
  int tail = sweep_points;
  x &= 0x03e0;
  i = 0;
  while (head < tail) {
    i = (head + tail) / 2;
    if (x == CELL_X0(index[i]))
      break;

    if (x < CELL_X0(index[i]))
      tail = i+1;
    else
      head = i;
  }

  if (x != CELL_X0(index[i]))
    return FALSE;

  j = i;
  while (j > 0 && x == CELL_X0(index[j-1]))
    j--;
  *i0 = j;
  j = i;
  while (j < 100 && x == CELL_X0(index[j+1]))
    j++;
  *i1 = j;
  return TRUE;
}

void
draw_refpos(int w, int h, int x, int y, int c)
{
  // draw triangle
  int i, j;
  if (y < -3 || y > 32 + 3)
    return;
  for (j = 0; j < 3; j++) {
    int j0 = 6 - j*2;
    for (i = 0; i < j0; i++) {
      int x0 = x + i-5;
      int y0 = y - j;
      int y1 = y + j;
      if (y0 >= 0 && y0 < h && x0 >= 0 && x0 < w)
        lcd_buffer[y0*w+x0] = c;
      if (j != 0 && y1 >= 0 && y1 < h && x0 >= 0 && x0 < w)
        lcd_buffer[y1*w+x0] = c;
    }
  }
}


void
cell_draw_refpos(int m, int n, int w, int h)
{
  int x0 = m * CELLWIDTH;
  int y0 = n * CELLHEIGHT;
  int t;
  for (t = 0; t < TRACES_MAX; t++) {
    if (!trace[t].enabled)
      continue;
    if (trace[t].type == TRC_SMITH || trace[t].type == TRC_POLAR)
      continue;
    int x = 0 - x0 +CELLOFFSETX;
    int y = 8*GRIDY - (int)(trace[t].refpos * GRIDY) - y0;
    if (x > -5 && x < w && y >= -3 && y < h+3)
      draw_refpos(w, h, x, y, config.trace_color[t]);
  }
}

void
draw_marker(int w, int h, int x, int y, int c, int ch)
{
  int i, j;
  for (j = 10; j >= 0; j--) {
    int j0 = j / 2;
    for (i = -j0; i <= j0; i++) {
      int x0 = x + i;
      int y0 = y - j;
      int cc = c;
      if (j <= 9 && j > 2 && i >= -1 && i <= 3) {
        uint16_t bits = x5x7_bits[(ch * 7) + (9-j)];
        if (bits & (0x8000>>(i+1)))
          cc = 0;
      }
      if (y0 >= 0 && y0 < h && x0 >= 0 && x0 < w)
        lcd_buffer[y0*w+x0] = cc;
    }
  }
}

void
marker_position(int m, int t, int *x, int *y)
{
  uint32_t index = trace_index[t][markers[m].index];
  *x = CELL_X(index);
  *y = CELL_Y(index);
}

int
search_nearest_index(int x, int y, int t)
{
  uint32_t *index = trace_index[t];
  int min_i = -1;
  int min_d = 1000;
  int i;
  for (i = 0; i < sweep_points; i++) {
    int16_t dx = x - CELL_X(index[i]) - OFFSETX;
    int16_t dy = y - CELL_Y(index[i]) - OFFSETY;
    if (dx < 0) dx = -dx;
    if (dy < 0) dy = -dy;
    if (dx > 20 || dy > 20)
      continue;
    int d = dx*dx + dy*dy;
    if (d < min_d) {
      min_i = i;
    }
  }

  return min_i;
}

void
cell_draw_markers(int m, int n, int w, int h)
{
  int x0 = m * CELLWIDTH;
  int y0 = n * CELLHEIGHT;
  int t, i;
  for (i = 0; i < 4; i++) {
    if (!markers[i].enabled)
      continue;
    for (t = 0; t < TRACES_MAX; t++) {
      if (!trace[t].enabled)
        continue;
      uint32_t index = trace_index[t][markers[i].index];
      int x = CELL_X(index) - x0;
      int y = CELL_Y(index) - y0;
      if (x > -6 && x < w+6 && y >= 0 && y < h+12)
        draw_marker(w, h, x, y, config.trace_color[t], '1' + i);
    }
  }
}

void
markmap_marker(int marker)
{
  int t;
  if (!markers[marker].enabled)
    return;
  for (t = 0; t < TRACES_MAX; t++) {
    if (!trace[t].enabled)
      continue;
    uint32_t index = trace_index[t][markers[marker].index];
    int x = CELL_X(index);
    int y = CELL_Y(index);
    int m = x>>5;
    int n = y>>5;
    mark_map(m, n);
    if ((x&31) < 6)
      mark_map(m-1, n);
    if ((x&31) > 32-6)
      mark_map(m+1, n);
    if ((y&31) < 12) {
      mark_map(m, n-1);
      if ((x&31) < 6)
        mark_map(m-1, n-1);
      if ((x&31) > 32-6)
        mark_map(m+1, n-1);
    }
  }
}

void
markmap_all_markers(void)
{
  int i;
  for (i = 0; i < 4; i++) {
    if (!markers[i].enabled)
      continue;
    markmap_marker(i);
  }
  markmap_upperarea();
}

/*
=======================================
    把图像信息放到 CELL 中
=======================================
*/
void draw_cell(int m, int n)
{
  int x0 = m * CELLWIDTH;
  int y0 = n * CELLHEIGHT;
  int x0off = x0 - CELLOFFSETX;
  int w = CELLWIDTH;
  int h = CELLHEIGHT;
  int x, y;
  int i0, i1;
  int i;
  int t;

  if (x0off + w > area_width)
    w = area_width - x0off;
  if (y0 + h > area_height)
    h = area_height - y0;
  if (w <= 0 || h <= 0)
    return;

  uint16_t grid_mode = 0;
  for (t = 0; t < TRACES_MAX; t++) { // 共 4 条曲线
    if (!trace[t].enabled)
      continue;

    if (trace[t].type == TRC_SMITH)
      grid_mode |= GRID_SMITH;
    //else if (trace[t].type == TRC_ADMIT)
    //  grid_mode |= GRID_ADMIT;
    else if (trace[t].type == TRC_POLAR)
      grid_mode |= GRID_POLAR;
    else
      grid_mode |= GRID_RECTANGULAR;
  }

  PULSE;
  /* draw grid */
  if (grid_mode & GRID_RECTANGULAR) {
    for (x = 0; x < w; x++) {
      uint16_t c = rectangular_grid_x(x+x0off);
      for (y = 0; y < h; y++)
        lcd_buffer[y * w + x] = c;
    }
    for (y = 0; y < h; y++) {
      uint16_t c = rectangular_grid_y(y+y0);
      for (x = 0; x < w; x++)
        if (x+x0off >= 0 && x+x0off <= WIDTH)
          lcd_buffer[y * w + x] |= c;
    }
  } else {
    memset(lcd_buffer, 0, sizeof lcd_buffer);
  }
  if (grid_mode & (GRID_SMITH|GRID_ADMIT|GRID_POLAR)) {
    for (y = 0; y < h; y++) {
      for (x = 0; x < w; x++) {
        uint16_t c = 0;
        if (grid_mode & GRID_SMITH)
          c = smith_grid(x+x0off, y+y0);
        else if (grid_mode & GRID_ADMIT)
          c = smith_grid3(x+x0off, y+y0);
        //c = smith_grid2(x+x0, y+y0, 0.5);
        else if (grid_mode & GRID_POLAR)
          c = polar_grid(x+x0off, y+y0);
        lcd_buffer[y * w + x] |= c;
      }
    }
  }
  PULSE;

#if 1
  /* draw rectanglar plot */
  for (t = 0; t < TRACES_MAX; t++) {
    if (!trace[t].enabled)
      continue;
    if (trace[t].type == TRC_SMITH || trace[t].type == TRC_POLAR)
      continue;
    
    if (search_index_range_x(x0, trace_index[t], &i0, &i1)) {
      if (i0 > 0)
        i0--;
      if (i1 < SWEEP_POINTS-1)
        i1++;
      for (i = i0; i < i1; i++) {
        int x1 = CELL_X(trace_index[t][i]);
        int x2 = CELL_X(trace_index[t][i+1]);
        int y1 = CELL_Y(trace_index[t][i]);
        int y2 = CELL_Y(trace_index[t][i+1]);
        int c = config.trace_color[t];
        cell_drawline(w, h, x1 - x0, y1 - y0, x2 - x0, y2 - y0, c);
      }
    }
  }
#endif
#if 1
  /* draw polar plot */
  for (t = 0; t < TRACES_MAX; t++) {
    int c = config.trace_color[t];
    if (!trace[t].enabled)
      continue;
    if (trace[t].type != TRC_SMITH && trace[t].type != TRC_POLAR)
      continue;

    for (i = 1; i < sweep_points; i++) {
      //uint32_t index = trace_index[t][i];
      //uint32_t pindex = trace_index[t][i-1];
      //if (!CELL_P(index, x0, y0) && !CELL_P(pindex, x0, y0))
      //  continue;
      int x1 = CELL_X(trace_index[t][i-1]);
      int x2 = CELL_X(trace_index[t][i]);
      int y1 = CELL_Y(trace_index[t][i-1]);
      int y2 = CELL_Y(trace_index[t][i]);
      cell_drawline(w, h, x1 - x0, y1 - y0, x2 - x0, y2 - y0, c);
    }
  }
#endif

  PULSE;
  //draw marker symbols on each trace
  cell_draw_markers(m, n, w, h);
  // draw trace and marker info on the top
  cell_draw_marker_info(m, n, w, h);
  PULSE;

  if (m == 0) // refpos 总在 m=0 的 Cell
    cell_draw_refpos(m, n, w, h);

  nt35510_bulk_x2(OFFSETX + x0off, OFFSETY + y0, w, h);
}

void
draw_all_cells(void)
{
  int m, n;
  for (m = 0; m < (area_width+CELLWIDTH-1) / CELLWIDTH; m++)  // 0-9 -> 0-10
    for (n = 0; n < (area_height+CELLHEIGHT-1) / CELLHEIGHT; n++) {  // 0-8
      if (is_mapmarked(m, n)) // 只绘制标记的CELL
        draw_cell(m, n);
      //ui_process();
      //if (operation_requested)
      //  return;
    }

  // keep current map for update
  swap_markmap();
  // clear map for next plotting
  clear_markmap();
}

void
redraw_marker(int marker, int update_info)
{
  // mark map on new position of marker
  markmap_marker(marker);

  // mark cells on marker info
  if (update_info) {
      markmap[current_mappage][0] = 0xffff;
      #if (USE_ILI_LCD == 0)
      markmap[current_mappage][1] = 0xffff;
      #endif
  }

  draw_all_cells();
}

void
request_to_draw_cells_behind_menu(void)
{
#if USE_ILI_LCD
  int n, m;
  for (m = 7; m <= 9; m++)
    for (n = 0; n < 8; n++)
      mark_map(m, n);
  redraw_requested = TRUE;
#else
  int n, m;
  for (m = 8; m <= 10; m++)
    for (n = 0; n < 8; n++)
      mark_map(m, n);
  redraw_requested = TRUE;
#endif
}

void
request_to_draw_cells_behind_numeric_input(void)
{
#if USE_ILI_LCD
  int n, m;
  for (m = 0; m <= 9; m++)
    for (n = 6; n < 8; n++)
      mark_map(m, n);
  redraw_requested = TRUE;
#else
  int n, m;
  for (m = 0; m <= 10; m++)
    for (n = 6; n < 8; n++)
      mark_map(m, n);
  redraw_requested = TRUE;
#endif
}

/*
=======================================
    w  CELL 的宽度
    h  CELL 的高度
    ch 某个字符
=======================================
*/
void cell_drawchar_5x7(int w, int h, uint8_t ch, int x, int y, uint16_t fg, int invert)
{
  uint16_t bits;
  int c, r;
  if (y <= -7 || y >= h || x <= -5 || x >= w)
    return;
  for(c = 0; c < 7; c++) {
    if ((y + c) < 0 || (y + c) >= h)
      continue;
    bits = x5x7_bits[(ch * 7) + c];
    if (invert)
      bits = ~bits;
    for (r = 0; r < 5; r++) {
      if ((x+r) >= 0 && (x+r) < w && (0x8000 & bits)) 
        lcd_buffer[(y+c)*w + (x+r)] = fg;
      bits <<= 1;
    }
  }
}

void
cell_drawstring_5x7(int w, int h, char *str, int x, int y, uint16_t fg)
{
  while (*str) {
    cell_drawchar_5x7(w, h, *str, x, y, fg, FALSE);
    x += 5;
    str++;
  }
}

void
cell_drawstring_invert_5x7(int w, int h, char *str, int x, int y, uint16_t fg, int invert)
{
  while (*str) {
    cell_drawchar_5x7(w, h, *str, x, y, fg, invert);
    x += 5;
    str++;
  }
}

/*
=======================================
    w  CELL 的宽度
    h  CELL 的高度
    ch 某个字符
=======================================
*/
void cell_drawchar_06x13(int w, int h, uint8_t ch, int x, int y, uint16_t fg, int invert)
{
  uint16_t bits;
  int c, r;
  if (y <= -13 || y >= h || x <= -6 || x >= w)
    return;
  for(c = 0; c < 13; c++) {
    if ((y + c) < 0 || (y + c) >= h)
      continue;
    bits = _06x13_bits[(ch * 13) + c];
    if (invert)
      bits = ~bits;
    for (r = 0; r < 6; r++) {
      if ((x+r) >= 0 && (x+r) < w && (0x8000 & bits)) 
        lcd_buffer[(y+c)*w + (x+r)] = fg;
      bits <<= 1;
    }
  }
}

void
cell_drawstring_06x13(int w, int h, char *str, int x, int y, uint16_t fg)
{
  while (*str) {
    cell_drawchar_06x13(w, h, *str, x, y, fg, FALSE);
    x += 6;
    str++;
  }
}

void
cell_drawstring_invert_06x13(int w, int h, char *str, int x, int y, uint16_t fg, int invert)
{
  while (*str) {
    cell_drawchar_06x13(w, h, *str, x, y, fg, invert);
    x += 6;
    str++;
  }
}

/*
=======================================
    显示 mark 点的信息
=======================================
*/
void cell_draw_marker_info(int m, int n, int w, int h)
{
    char buf[24];
    int t;

    if (n < 0 || n > 1)
        return;
    if (active_marker < 0)
        return;

    int idx = markers[active_marker].index;
    int j = 0;
    for (t = 0; t < TRACES_MAX; t++) {
        if (!trace[t].enabled)
            continue;
        int xpos = 1 + (j%2)*P_CENTER_X;
        #if USE_ILI_LCD
        int ypos = 1 + (j/2)*7;
        #else
        int ypos = 1 + (j/2)*13;
        #endif
        xpos -= m * CELLWIDTH -CELLOFFSETX;
        ypos -= n * CELLHEIGHT;
        if (trace[t].channel == 0) {
            chsnprintf(buf, sizeof buf, "S11");
        } else {
            chsnprintf(buf, sizeof buf, "S21");
        }
        if (n == 0)
        {
            #if USE_ILI_LCD
            cell_drawstring_invert_5x7(w, h, buf, xpos, ypos, config.trace_color[t], t == uistat.current_trace);
            xpos += 20;
            trace_get_info(t, buf, sizeof buf);
            cell_drawstring_5x7(w, h, buf, xpos, ypos, config.trace_color[t]);
            xpos += 64;
            trace_get_value_string(t, buf, sizeof buf, measured[trace[t].channel][idx], frequencies[idx]);
            cell_drawstring_5x7(w, h, buf, xpos, ypos, config.trace_color[t]);
            #else
            cell_drawstring_invert_06x13(w, h, buf, xpos, ypos, config.trace_color[t], t == uistat.current_trace);
            xpos += 22;
            trace_get_info(t, buf, sizeof buf);
            cell_drawstring_06x13(w, h, buf, xpos, ypos, config.trace_color[t]);
            xpos += 77;
            trace_get_value_string(t, buf, sizeof buf, measured[trace[t].channel][idx], frequencies[idx]);
            cell_drawstring_06x13(w, h, buf, xpos, ypos, config.trace_color[t]);
            #endif
        }
        j++;
    }

    // draw marker frequency
    #if USE_ILI_LCD
    int xpos = 192;
    int ypos = 1 + (j/2)*7;
    xpos -= m * CELLWIDTH -CELLOFFSETX;
    ypos -= n * CELLHEIGHT;
    chsnprintf(buf, sizeof buf, "%d:", active_marker + 1);
    cell_drawstring_5x7(w, h, buf, xpos, ypos, 0xffff);
    xpos += 16;
    frequency_string(buf, sizeof buf, frequencies[idx]);
    cell_drawstring_5x7(w, h, buf, xpos, ypos, 0xffff);

    // draw marker delta
    if (active_marker != previous_marker && markers[previous_marker].enabled) {
        int idx0 = markers[previous_marker].index;
        xpos = 192;
        xpos -= m * CELLWIDTH -CELLOFFSETX;
        ypos += 7;
        chsnprintf(buf, sizeof buf, "\001%d:", previous_marker+1);
        cell_drawstring_5x7(w, h, buf, xpos, ypos, 0xffff);
        xpos += 16;
        frequency_string(buf, sizeof buf, frequencies[idx] - frequencies[idx0]);
        cell_drawstring_5x7(w, h, buf, xpos, ypos, 0xffff);
    }
    #else
    int xpos = 192+30;
    int ypos = 1 + (j/2)*13;
    xpos -= m * CELLWIDTH -CELLOFFSETX;
    ypos -= n * CELLHEIGHT;
    chsnprintf(buf, sizeof buf, "%d:", active_marker + 1);
    cell_drawstring_06x13(w, h, buf, xpos, ypos, 0xffff);
    xpos += 19;
    frequency_string(buf, sizeof buf, frequencies[idx]);
    cell_drawstring_06x13(w, h, buf, xpos, ypos, 0xffff);

    // draw marker delta
    if (active_marker != previous_marker && markers[previous_marker].enabled) {
        int idx0 = markers[previous_marker].index;
        xpos = 192+30;
        xpos -= m * CELLWIDTH -CELLOFFSETX;
        ypos += 13;
        chsnprintf(buf, sizeof buf, "\001%d:", previous_marker+1);
        cell_drawstring_06x13(w, h, buf, xpos, ypos, 0xffff);
        xpos += 19;
        frequency_string(buf, sizeof buf, frequencies[idx] - frequencies[idx0]);
        cell_drawstring_06x13(w, h, buf, xpos, ypos, 0xffff);
    }
    /*
    int xpos = 192+30;
    int ypos = 1 + (j/2)*13;
    xpos -= m * CELLWIDTH -CELLOFFSETX;
    ypos -= n * CELLHEIGHT;
    chsnprintf(buf, sizeof buf, "%d:", active_marker + 1);
    cell_drawstring_5x7(w, h, buf, xpos, ypos, 0xffff);
    xpos += 16;
    frequency_string(buf, sizeof buf, frequencies[idx]);
    cell_drawstring_5x7(w, h, buf, xpos, ypos, 0xffff);

    // draw marker delta
    if (active_marker != previous_marker && markers[previous_marker].enabled) {
        int idx0 = markers[previous_marker].index;
        xpos = 192+30;
        xpos -= m * CELLWIDTH -CELLOFFSETX;
        ypos += 7;
        chsnprintf(buf, sizeof buf, "\001%d:", previous_marker+1);
        cell_drawstring_5x7(w, h, buf, xpos, ypos, 0xffff);
        xpos += 16;
        frequency_string(buf, sizeof buf, frequencies[idx] - frequencies[idx0]);
        cell_drawstring_5x7(w, h, buf, xpos, ypos, 0xffff);
    }*/
    #endif
}

void
frequency_string(char *buf, size_t len, int32_t freq)
{
  if (freq < 0) {
    freq = -freq;
    *buf++ = '-';
    len -= 1;
  }
  if (freq < 1000) {
    chsnprintf(buf, len, "%d Hz", (int)freq);
  } else if (freq < 1000000) {
    chsnprintf(buf, len, "%d.%03d kHz",
             (int)(freq / 1000),
             (int)(freq % 1000));
  } else {
    chsnprintf(buf, len, "%d.%03d %03d MHz",
             (int)(freq / 1000000),
             (int)((freq / 1000) % 1000),
             (int)(freq % 1000));
  }
}

void
draw_frequencies(void)
{
  char buf[24];
  if (frequency1 > 0) {
    int start = frequency0;
    int stop = frequency1;
    strcpy(buf, "START ");
    frequency_string(buf+6, 24-6, start);
    strcat(buf, "    ");
    #if USE_ILI_LCD
    nt35510_drawstring_5x7_x2(buf, OFFSETX, HEIGHT, 0xffff, 0x0000);
    #else
    nt35510_drawstring_5x7(buf, OFFSETX, HEIGHT, 0xffff, 0x0000);
    #endif
    strcpy(buf, "STOP ");
    frequency_string(buf+5, 24-5, stop);
    strcat(buf, "    ");
    #if USE_ILI_LCD
    nt35510_drawstring_5x7_x2(buf, 205, HEIGHT, 0xffff, 0x0000);
    #else
    nt35510_drawstring_5x7(buf, 270, HEIGHT, 0xffff, 0x0000);
    #endif
  } else if (frequency1 < 0) {
    int fcenter = frequency0;
    int fspan = -frequency1;
    strcpy(buf, "CENTER ");
    frequency_string(buf+7, 24-7, fcenter);
    strcat(buf, "    ");
    #if USE_ILI_LCD
    nt35510_drawstring_5x7_x2(buf, OFFSETX, HEIGHT, 0xffff, 0x0000);
    #else
    nt35510_drawstring_5x7(buf, OFFSETX, HEIGHT, 0xffff, 0x0000);
    #endif
    strcpy(buf, "SPAN ");
    frequency_string(buf+5, 24-5, fspan);
    strcat(buf, "    ");
    #if USE_ILI_LCD
    nt35510_drawstring_5x7_x2(buf, 205, HEIGHT, 0xffff, 0x0000);
    #else
    nt35510_drawstring_5x7(buf, 270, HEIGHT, 0xffff, 0x0000);
    #endif
  } else {
    int fcenter = frequency0;
    chsnprintf(buf, 24, "CW %d.%03d %03d MHz    ",
               (int)(fcenter / 1000000),
               (int)((fcenter / 1000) % 1000),
               (int)(fcenter % 1000));
    nt35510_drawstring_5x7(buf, OFFSETX, HEIGHT, 0xffff, 0x0000);
    chsnprintf(buf, 24, "                             ");
    #if USE_ILI_LCD
    nt35510_drawstring_5x7_x2(buf, 205, HEIGHT, 0xffff, 0x0000);
    #else
    nt35510_drawstring_5x7(buf, 270, HEIGHT, 0xffff, 0x0000);
    #endif
  }
}

void
draw_cal_status(void)
{
#if USE_ILI_LCD
  int x = 0;
  int y = 100;
#define YSTEP 7
  nt35510_fill_x2(0, y, 10, 6*YSTEP, 0x0000);
  if (cal_status & CALSTAT_APPLY) {
    char c[3] = "C0";
    if (cal_status & CALSTAT_INTERPOLATED)
      c[0] = 'c';
    if (active_props == &current_props)
      c[1] = '*';
    else
      c[1] += lastsaveid;
    nt35510_drawstring_5x7_x2(c, x, y, 0xffff, 0x0000);
    y += YSTEP;
  }

  if (cal_status & CALSTAT_ED) {
    nt35510_drawstring_5x7_x2("D", x, y, 0xffff, 0x0000);
    y += YSTEP;
  }
  if (cal_status & CALSTAT_ER) {
    nt35510_drawstring_5x7_x2("R", x, y, 0xffff, 0x0000);
    y += YSTEP;
  }
  if (cal_status & CALSTAT_ES) {
    nt35510_drawstring_5x7_x2("S", x, y, 0xffff, 0x0000);
    y += YSTEP;
  }
  if (cal_status & CALSTAT_ET) {
    nt35510_drawstring_5x7_x2("T", x, y, 0xffff, 0x0000);
    y += YSTEP;
  }
  if (cal_status & CALSTAT_EX) {
    nt35510_drawstring_5x7_x2("X", x, y, 0xffff, 0x0000);
    y += YSTEP;
  }
#else
  int x = 0;
  int y = 80*2;
#define YSTEP 24
  nt35510_fill(0, y, 12*2, 24*6, 0x0000);
  if (cal_status & CALSTAT_APPLY) {
    char c[3] = "C0";
    if (cal_status & CALSTAT_INTERPOLATED)
      c[0] = 'c';
    if (active_props == &current_props)
      c[1] = '*';
    else
      c[1] += lastsaveid;
    // nt35510_drawstring_5x7_x2(c, x, y, 0xffff, 0x0000);
    nt35510_drawstring(&font_12x24, c, x, y, 0xffff, 0x0000);
    y += YSTEP;
  }

  if (cal_status & CALSTAT_ED) {
    // nt35510_drawstring_5x7_x2("D", x, y, 0xffff, 0x0000);
    nt35510_drawstring(&font_12x24, "D", x, y, 0xffff, 0x0000);
    y += YSTEP;
  }
  if (cal_status & CALSTAT_ER) {
    // nt35510_drawstring_5x7_x2("R", x, y, 0xffff, 0x0000);
    nt35510_drawstring(&font_12x24, "R", x, y, 0xffff, 0x0000);
    y += YSTEP;
  }
  if (cal_status & CALSTAT_ES) {
    // nt35510_drawstring_5x7_x2("S", x, y, 0xffff, 0x0000);
    nt35510_drawstring(&font_12x24, "S", x, y, 0xffff, 0x0000);
    y += YSTEP;
  }
  if (cal_status & CALSTAT_ET) {
    // nt35510_drawstring_5x7_x2("T", x, y, 0xffff, 0x0000);
    nt35510_drawstring(&font_12x24, "T", x, y, 0xffff, 0x0000);
    y += YSTEP;
  }
  if (cal_status & CALSTAT_EX) {
    // nt35510_drawstring_5x7_x2("X", x, y, 0xffff, 0x0000);
    nt35510_drawstring(&font_12x24, "X", x, y, 0xffff, 0x0000);
    y += YSTEP;
  }
#endif
}

void
draw_battery_status()
{
    int w = 10, h = 14;
    int x = 0, y = 0;
    int i, c;
    uint16_t *buf = lcd_buffer;
    uint8_t vbati = vbat2bati(vbat);
    uint16_t col = vbati == 0 ? BRG556(0, 255, 0) : BRG556(0, 0, 240);
    memset(lcd_buffer, 0, w * h * 2);

    // battery head
    x = 3;
    buf[y * w + x++] = col;
    buf[y * w + x++] = col;
    buf[y * w + x++] = col;
    buf[y * w + x++] = col;

    y++;
    x = 3;
    buf[y * w + x++] = col;
    x++; x++;
    buf[y * w + x++] = col;

    y++;
    x = 1;
    for (i = 0; i < 8; i++)
        buf[y * w + x++] = col;

    for (c = 0; c < 3; c++) {
        y++;
        x = 1;
        buf[y * w + x++] = col;
        x++; x++; x++; x++; x++; x++;
        buf[y * w + x++] = col;

        y++;
        x = 1;
        buf[y * w + x++] = col;
        x++;
        for (i = 0; i < 4; i++)
            buf[y * w + x++] = ( ((c+1) * 25) >= (100 - vbati)) ? col : 0;
        x++;
        buf[y * w + x++] = col;

        y++;
        x = 1;
        buf[y * w + x++] = col;
        x++;
        for (i = 0; i < 4; i++)
            buf[y * w + x++] = ( ((c+1) * 25) >= (100 - vbati)) ? col : 0;
        x++;
        buf[y * w + x++] = col;
    }

    // battery foot
    y++;
    x = 1;
    buf[y * w + x++] = col;
    x++; x++; x++; x++; x++; x++;
    buf[y * w + x++] = col;

    y++;
    x = 1;
    for (i = 0; i < 8; i++)
        buf[y * w + x++] = col;

    nt35510_bulk_x2(0, 1, w, h);
}

void
request_to_redraw_grid(void)
{
  force_set_markmap();
  redraw_requested = TRUE;
}

void
redraw_frame(void)
{
  nt35510_fill_x2(0, 0, LCD_WIDTH, LCD_HEIGHT, 0);
  draw_frequencies();
  draw_cal_status();
}

/*void
redraw_all(void)
{
  redraw();
  force_set_markmap();
  draw_all_cells();
  }*/

void
plot_init(void)
{
  force_set_markmap();
}
