flyoob/NanoVNA-F/Usr/Wav.c

#include <stdint.h>

const int8_t welcom_8bit[] =
{
127,127,127,127,127,127,127,127,127,127,127,127,127,127,127,127,127,127,127,127,127,127,127,127,127,127,127,127,127,127,127,127,127,127,127,127,127,127,127,127,127,127,127,127,127,127,127,127,127,127,127,127,127,127,127,127,127,127,127,127,127,127,127,127,127,127,127,127,127,127,127,127,127,127,127,127,127,127,127,127,127,127,127,127,127,127,127,127,127,127,127,127,127,127,127,127,127,127,127,127,127,127,127,127,127,127,127,127,127,127,127,127,127,127,127,127,127,127,127,127,127,127,127,127,127,127,127,127,127,127,127,127,127,127,127,127,127,127,127,127,127,127,127,127,127,127,127,127,127,127,127,127,127,127,127,127,127,127,127,127,127,127,127,127,127,127,127,127,127,127,127,127,127,127,127,127,127,127,127,127,127,127,127,127,127,127,127,127,127,127,127,127,127,127,127,127,127,127,127,127,127,126,127,127,127,127,127,127,126,126,126,126,127,127,127,127,127,127,127,127,127,127,126,126,127,127,127,127,127,127,126,126,126,126,127,127,127,127,127,127,127,127,126,126,127,127,127,127,127,127,127,127,126,126,126,126,127,127,127,127,127,127,126,125,125,127,127,127,127,127,127,127,126,126,126,126,127,127,127,127,127,127,126,126,127,127,127,127,127,126,126,126,127,127,127,127,127,127,127,127,126,126,126,127,127,127,127,127,127,127,127,126,126,126,126,127,127,127,127,127,127,127,127,127,126,126,126,126,127,127,127,127,127,127,127,127,126,126,126,127,127,127,127,127,127,127,127,127,126,127,127,127,127,127,127,127,126,126,125,126,127,127,127,127,127,127,127,126,126,126,126,126,127,127,127,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
};
