flyoob/NanoVNA-F/Usr/numfont20x24.c

/*
 * Copyright (c) 2014-2015, TAKAHASHI Tomohiro (TTRFTECH) edy555@gmail.com
 * All rights reserved.
 *
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
 * You should have received a copy of the GNU General Public License
 * along with GNU Radio; see the file COPYING.  If not, write to
 * the Free Software Foundation, Inc., 51 Franklin Street,
 * Boston, MA 02110-1301, USA.
 */

#include <stdint.h>

const uint32_t numfont20x24[][24] = {
		{	// 0
		// 0b00000111111111000000100000000000,
		// 0b00011111111111110000000000000000,
		// 0b00111111111111111000000000000000,
		// 0b01111111111111111100000000000000,
		// 0b01111110000011111100000000000000,
		// 0b11111100000001111110000000000000,
		// 0b11111000000000111110000000000000,
		// 0b11111000000000111110000000000000,
		// 0b11111000000000111110000000000000,
		// 0b11111000000000111110000000000000,
		// 0b11111000000000111110000000000000,
		// 0b11111000000000111110000000000000,
		// 0b11111000000000111110000000000000,
		// 0b11111000000000111110000000000000,
		// 0b11111000000000111110000000000000,
		// 0b11111000000000111110000000000000,
		// 0b11111100000001111110000000000000,
		// 0b01111110000011111100000000000000,
		// 0b01111111111111111100000000000000,
		// 0b00111111111111111000000000000000,
		// 0b00011111111111110000000000000000,
		// 0b00000111111111000000100000000000,
		// 0b00000000000000000000000000000000,
		// 0b00000000000000000000000000000000
133957632	,
536805376	,
1073709056	,
2147467264	,
2114961408	,
4228374528	,
4161003520	,
4161003520	,
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
		// 0b00000000011000000000100000000000,
		// 0b00000000000000000000000000000000,
		// 0b00000000000000000000000000000000
0	,
0	,
0	,
0	,
0	,
0	,
1073725440	,
1073725440	,
811646976	,
409042944	,
207814656	,
107347968	,
57409536	,
33030144	,
15728640	,
6291456	,
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
		},

};
