flyoob/NanoVNA-F/(commit log)

2019-07-18 优化数字条模式下触摸操作
2019-07-18 数字2取模修复
2019-07-18 完善触摸屏校准
2019-07-19 加入 BIN 文件生成脚本
2019-07-23 同步 edy555 最新代码，修正 S11 错误。
    [appvna.c]
2019-07-24 配置 APP
2019-07-25 生成跳转 APP
2019-07-25 修改 VECT_TAB_OFFSET
2019-07-26 适配硬件 V2.1
2019-07-26 Si5531 超频到 1200MHz 时不稳定，超频上限设置为：1180MHz
2019-07-27 规范 LCD 驱动命名
2019-07-29 加入 Beep 测试
2019-08-01 上传谍照
2019-08-01 JPG 扩展名大写
2019-08-01 CW 模式下频率点限制
2019-08-02 使用相同优先级
2019-08-04 键盘模式下退格不清除问题
2019-08-04 CODEC 通道切换时加长延时，确保信号稳定
2019-08-05 优化 logmag 和 swr 在计算无穷大和无穷小时的处理方式
2019-08-05 扫描增益修改
2019-08-05 修改默认曲线设置
2019-08-12 改 STM32 为 I2S 从机，解决一些数据错乱问题
    [NanoVNA-F.ioc, aic3204.c, appvna.c, main.c, si5351.c]
2019-08-13 避免 int 转 float 丢失精度
2019-08-14 1、use STM32F1 as I2S Master, AIC3204 as slave.（F1 作为 I2S 从机时会有数据错位问题，因此最终使用 F1 作为 I2S 主机） 2、Change XTAL to 12.288MHz. 3、expand measure freq to 1GHz.
    [NanoVNA-F.ioc, aic3204.c, appvna.c, main.c, nanovna.h, si5351.c]
2019-08-15 更换晶振后，修正 IQ sincos 表。Correct the IQ sincos table after replacing the crystal.
    [aic3204.c, appvna.c, dsp.c]
2019-08-16 上传最新样机图
2019-08-16 增加电池电压显示 / Add Battery voltage display
2019-08-16 使用 VREFINT 作为 ADC 参考电压 / Use VREFINT as the ADC reference voltage
2019-08-16 删除无用注释 / Delete useless comments
2019-08-16 增加开机画面 / Add boot screen
2019-08-16 删除无用变量
2019-08-16 menu: add feedback at correction/pause menu item
    [nanovna.h, ui.c]
2019-08-16 优化已校准状态下按钮显示 / Optimize button display in calibrated state
2019-10-07 1. Freq < 100M, Si5351 only use PLL_A as output. 2. Increase delay when si5351 reset pll.
    [appvna.c, si5351.c]
2019-10-07 1. Moving voltage value position 2. Beep test
2019-10-28 fix bug at freq = 100MHz.
    [si5351.c]
2019-10-28 Improve SPI FLASH driver.
2020-01-01 upload new version PCB V2.2 SMT_F
2023-08-02 上传原理图
2026-01-08 Update README.md
    修复图片链接
